philippedc/Arduino-Uno-Wind-Turbine-MPPT-Regulator/final v1.jpeg

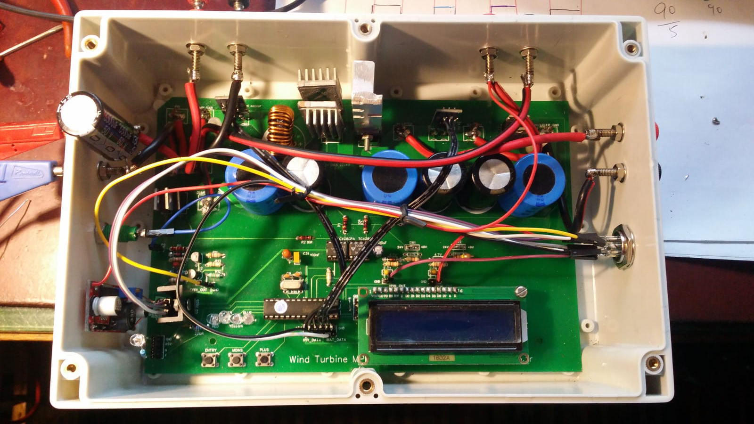
final v1.jpeg
