philippedc/Arduino-Uno-Wind-Turbine-MPPT-Regulator/photo_presentation2.png

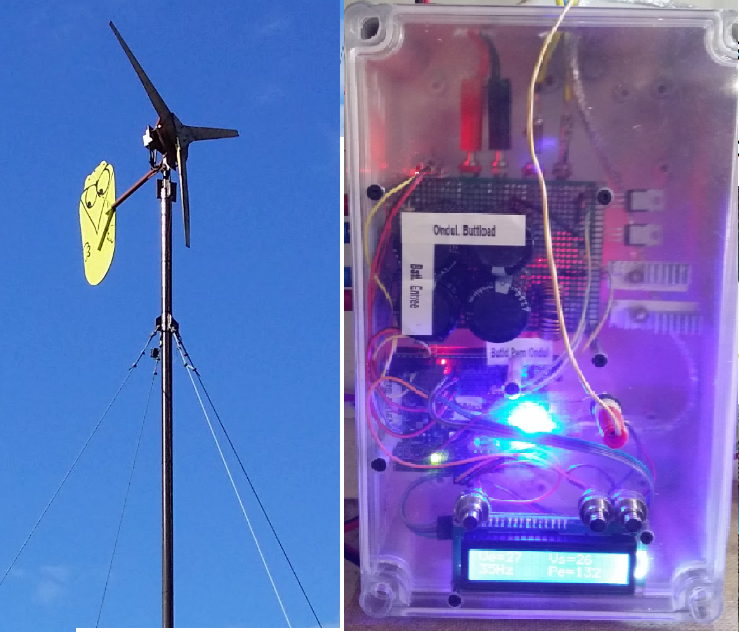
photo_presentation2.png
