philippedc/Arduino-Uno-Wind-Turbine-MPPT-Regulator/alltogether.png

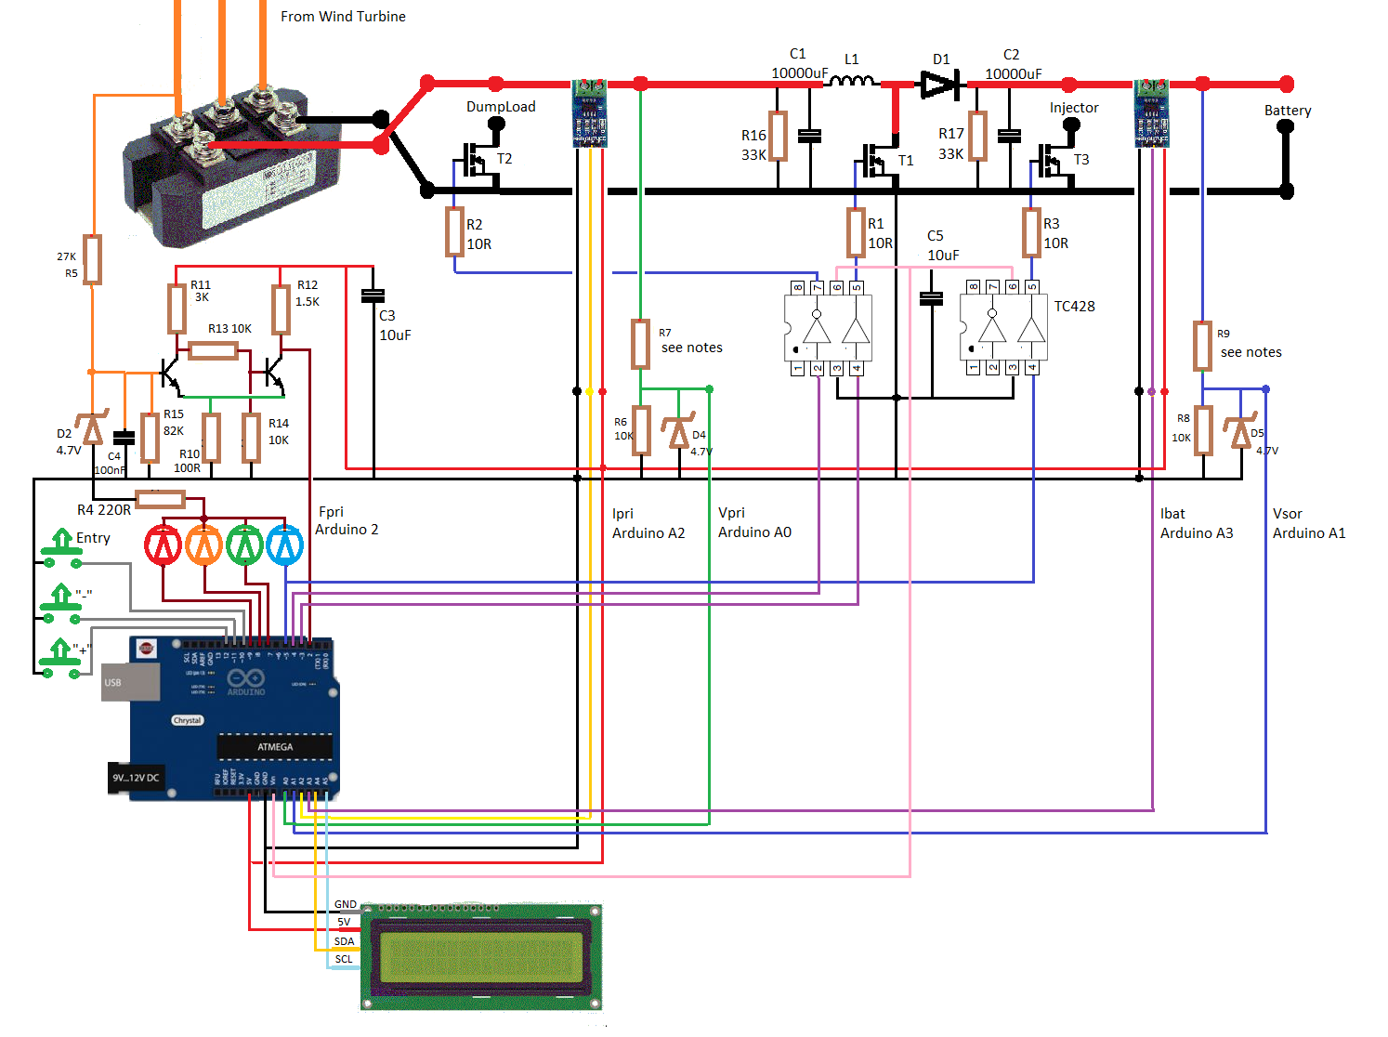
alltogether.png
