philippedc/Arduino-Uno-Wind-Turbine-MPPT-Regulator/(threads)

Thread 1 (2019-08-18):

Great, but how about breaks?

fhorst1, 2019-08-18:
I really love your solution and I am going to build 4 of them.
Buying from Aliexpress they only costs me US$ 35,- per controller :-)

But... how about brakes?
Dumpload is an expensive solution, and does not (???) protect the wind turbine during storm.

I live in a low wind speed area, off grid, 18 x 335w solar and 4x 800w wind.
This makes the wind turbines economical OK.
95% of the time wind speeds are below 5/ms
99.9% of the time the wind turbines will never get in the situation that they will overcharge the battery array (48v, 800ah lead-acid)

The 0.1%..
0r maybe even 0.001% of the time.
When there is a storm, the turbine needs to be stoped.

I'm thinking to use your dump load connection to activate a relay that shorts the 3 wires.
(with some delay) using Trigger Delay Timer Relais (https://aliexpress.com/item/32881401830.htm)
They are relatieve cheap ($0.80)  but is it possible to let the Arduino make a delayed short betweem the 3 wires?

fhorst1, 2019-08-19:
Hi Philippe,

As I currently have "0" electronic parts, I need to buy and look the liberty to make a list of the components for other people to purchase. (with price)

Personaly I like Aliexpress.
I have no connections to any of the shops, except I bought my stuff there 😃

Few questions:

For the capacitors, what is the right voltage? 80 or 100 or 200v?
The 4.7v Zeners, are they 0.5 or 1 W?
I can not find D3 in the "Alltogether.png"
Location of the 2N2222 and type (NPN?)
+++++++++++++++++++++++++++++++++++++++++++++++++++++++++++++++++

List of all materials:

One 3-phases power rectifier 150A ($7.75)
https://aliexpress.com/item/4000096163147.html

Dump load

Arduino Uno R3 ($3.25)
https://aliexpress.com/item/32213964945.html

current sensors ACS712 module, 20A ($1.25)
https://aliexpress.com/item/32831999370.html

CD display 1602 with I2C interface ($2.00)
https://aliexpress.com/item/32685612494.html

power transistor CMOS
10 x IRFB4110 ($4.25)
https://aliexpress.com/item/33024808392.html / https://aliexpress.com/item/33034172787.html
10 x IRFB4321 ($6.50)
https://aliexpress.com/item/32676708858.html
5 x IRFP4227PBF ($7.00)
https://aliexpress.com/item/32821398006.html

Schottky diode, (10 x MBR30200 = $1.75)
https://aliexpress.com/item/32876954612.html

One self of 100uH at least 15A ($4.00)
https://nl.aliexpress.com/item/32804834231.html (2 x 100uH/15A)
https://aliexpress.com/item/32804332271.html (= $5 for 3 x 100uH/15A)

electrolytic capacitors (4 x 4700uF/80v, total 10000uF or more)
what is the right voltage?? is it 80v, 100v or 200v?
https://aliexpress.com/item/33013414283.html ($11.00) (4 x 10000uF/80v)
https://aliexpress.com/item/32362931046.html ($15.00) (5 x 4700uF/80v)
2x CMOS driver circuits TC428 ($ 2.25) (for 10)
https://aliexpress.com/item/32900750979.html

2x transistors 2N2222 ($1.00) (for 100)
https://aliexpress.com/item/32944625673.html

4.7V zeners (*wattage?)
https://aliexpress.com/item/32865106042.html ($0.75) (100 x 0.5w/4.7v)
https://aliexpress.com/item/32949966611.html ($1.75) (100 x 1w/4.7v)
https://aliexpress.com/item/32864268102.html ($8.00) (100 0.5w mix 2-47v)

Electrolytic capacitors (* voltage?)
https://aliexpress.com/item/32886266800.html ($1.00) (20x 100nF, 100v)
https://aliexpress.com/item/33008525992.html ($1.00) (20x 10uF, 100v)

Resistors
set of 10 times 10, 100, 220, 1.5K, 3K, 10K, 33K, 82K Ω (NOT 27K, 91K or 380K!) 180K
https://aliexpress.com/item/32625249339.html ($4.00)
100x 27K = 27kΩ
https://aliexpress.com/item/32998450778.html ($0.15 + 0.36)
also for 24V (91K)
(alternative is to combine resistors from the set to 27, 91 or 380K)

Prototype shield for Arduino Uno R3 ($2.00)
https://aliexpress.com/item/33063183123.html
Total price: $ 48.75
(most aliexpress are free shiping, and rounded up, price is between $40 and 45,-)

extra:
Push buttons:
https://aliexpress.com/item/32992634198.html ($1.00)
Toggle switch
https://aliexpress.com/item/4000050986819.html ($0.50 for 20)
LED diode 5mm
https://aliexpress.com/item/32618633084.html ($1.00 for 5 x 20, W/Y/R/G/B)

+++++++++++++++++++++++++++++++++++++++++++++++++++++++++++++++++

Detailed List of components

C = Capacitator
C1 = 10.000uF 80V
C2 = 10.000uF 80V
C3 = 10uF 100v
C4 = 100nF (=0.1uF) 100v
C5 = 10uF 100v

D = Diode
D1 = Schottky diode MBR30200 parallelize 2 or more
D2 = Zener diode 4.7v
D3 = ???? can not find in schema
D4 = Zener diode 4.7v
D5 = Zener diode 4.7v

L = Inductor
L1 = 100uH 15A

R = Resistor
10R = 10 Ω = Brown, Black, Black, Gold	(need 3x)
100R = 100 Ω = Brown, Black, Brown, Gold	(need 1x)
220R = 220 Ω = Red, Red, Brown, Gold	(need 1x)
1.5K = 1.5 kΩ = Brown, Green, Red, Gold	(need 1x)
3K = 3 kΩ = Orange, Black, Red, Gold	(need 1x)
10K = 10 kΩ = Brown, Black, Orange, Gold	(need 4x)
27K = 27 kΩ = Red, Violet, Orange, Gold	(need 1x)
33K = 33 kΩ = Orange, Orange, Orange, Gold	(need 2x)
82K = 82 kΩ = Grey, Red, Orange, Gold	(need 1x)
91K = 91 kΩ = White, brown, orange, Gold (see notes)
180K = 180 kΩ =	Brown, Grey, Yellow, Gold (see notes)
360K =360 kΩ = Orange, blue, yellow, Gold (see notes)

R1 = 10R
R2 = 10R
R3 = 10R
R4 = 220R
R5 = 27K
R6 = 10K
R7 = see notes (91K (24V) or 180K (48V) or 2x91K)
R8 = 10K
R9 = see notes (180K (24V) or 360K (48V) or 2x180K)
R10= 100R
R11= 3K
R12= 1.5K
R13= 10K
R14= 10K
R15= 82K
R16= 33K
R17= 33K

T = Transistor
T1 = IRFB4110, IRFP4227 or IRFB4321
T2 = IRFB4110, IRFP4227 or IRFB4321
T3 = IRFB4110, IRFP4227 or IRFB4321

Transistor (with no letter or number) between R11, R12, R15 R10 and R14 are the 2N2222 NPN??

philippedc, 2019-09-04:
Hi @fhorst1 welcome here too :)
I do not understand why I do not receive notifications when I get any post, not here nor on arduino.cc...???
Yes I understand about brakes, we do not have this trouble with Piggott wind turbines.
What I suppose in case of very big storm, despite the dumpload is switch on, the voltage still increase over the nominal voltage value. In this case a duplicate dumpload circuit where the dumpload resistor is a short circuit may be the solution. Your link to the Trigger Delay Timer Relais does not operate.

Right now I'm working for a PCB. Then I will work for the version 2.0 with some changes : 10000uF capacitor for input of the inverter, low power state for the ATmega328 when it is not windy,  with an alarm (buzzer) if Vsor is under VsorMin, and an alarm if overload is reach in case of storm.

fhorst1, 2019-09-05:
Hi Philippe,

thank you for contacting me.

I have not that knowledge about electronics...
as far as I understand you (we) already use 10.000uf, yes?

[image: image.png]

I've done some googling about the ATmega328, if i understand it correctly
it is to replace the arduino ???
(but also that it is the arduino chip.... LOL sometimes being a noob makes
this difficult to understand)
I was not aware the Arduino uses much power :-)

Alarm (buzzer) if Vsor is under VsorMin,  does not make a whole lot sense
for me.
I use 6KW inverter to convert my 48 DC to 230AC. If the battery array is
below 10%, that one makes a loud beep and stops working.
Standby mode is already about 100 watts.... without really inverting energy.

That is just me, but i think most people will want to charge their
batteries, and want to convert this charge to AC230 (or110)
Most (maybe all?) inverters use more energy in standby mode than the MTTP
will.
A buzzer would give an alarm, but what do you expect people to do then this
buzzer goes?

Real life for me is when the inverter starts to cry, i know the batteries
are low and i need to put my laptop to hibernate.
The rest of the equipment (refrigerator, airconditioning etc) will just
stop working.

What would you like me to do with the MTTP's?
Turn them off?
I don't think that is a good idea, as controllers are meant just to be
there and do their thing, without constant interference.
Many systems are hybrid, have solar and wind.  When will the Vsor be under
VsorMin ?
Mostly at night, really early morning... You are sleeping.
Buzzer goes and you wake up, realising that the battery levels are too low.
What will you do?
Get out of bed to stumble in the night towards the setup and do??
:-)

I'm trying to help with your thoughts, how they will translate in practical
life (at least my life)

Why would the Trigger Delay Timer Relais not operate?
To my understanding simply short the 3 wires is a quick and dirty brake.
Abrupt, what might give damage to the turbine and/or blades.
short 2 of the 3 is like half brake, slowing down, adding a few seconds
later the third wire will give the same hard stop, but the speed is already
drastically reduced.
it would require 2 times the Trigger Delay Timer Relais per MTTP. First one
shorts 2 wires, second one shorts also 2 wires.
as there are 3, and the 2 pairs are different pairs, both shorts will give
a 3 wire short.
the trigger is the power (or pulse) you would normally provide to switch to
the dump-load, yes?

When the voltage is too high, the T2 makes the connection to the dump-load.
R2 is the line that triggers T2 to switch to dump-load, yes?
if I would not connect it to T2 i can connect it to both trigger
connections of the Trigger Delay Timer Relais  (who have different time
settings)

Please correct me if I'm wrong.
I am a beginner in reading those drawings, but a quick study :-)

The alarm if overload is reach in case of storm  you where planning, that
one would be even more nice for me to use as trigger.

A dump load resistor is for me not easy to accomplish.
Thailand is already HOT (last "summer" (hot season) 44 degrees Celsius)
I could use a heating element,
https://www.aliexpress.com/item/32991460130.html , mount them outside the
house.
In the rear situation the battery array is full (sunny, cool days, and
there is too much wind) they can be used as dumpload.

But it does leave me with the  typhoon  scenario. And thrust me, that is
not a doom scenario but realistic one.
A few days back there was a typhoon in Asia and its course was projected to
go directly over our house.....
Lucky for us it reduced in power when it was on land (Vietnam, after this
Cambodia)
Many floods in the area, but we got lucky, this time.
we don't need to buy a new roof :-)

But, typhoons are a real problem.

It would be great if you could help me to make the Trigger Delay Timer
Relais work.
I am not always at home, like now I an in Holland....
That typhoon almost made me change my flight to go back 2 weeks sooner..
Lucky lucky lucky :-)

When  can you have the PCB ready??

I am in Europe till the 14th, after this you need to send to Thailand :-)

When i'm back home, all the parts have arrived, and i am planing to start
soldering this thing and try to make it work.
If you like, you are more that welcome to help me.

I can't pay for your trip, but your stay would be free, and you can see
lovely Thailand Isaan country :-)
Trip from Bangkok to Udon Thani airport is no problem to pay for you, and
we pick you up at the airport .

My email address is fhorst@gmail.com
Whatsapp +31653653474
line: sirquest2017

Best regards,

Frank
.

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

philippedc, 2019-09-10:
Hi, when do you plan to build the regulators ?
I'm working on the PCB, and V2 also, but before I would like to finish the bench of measure, with an anemometer, to be able to measure the benefit of the device.
My email is dcphilippe"at" yahoo.fr
Thanks

philippedc, 2019-09-10:
> it would require 2 times the Trigger Delay Timer Relais per MTTP. First one
shorts 2 wires, second one shorts also 2 wires.
as there are 3, and the 2 pairs are different pairs, both shorts will give
a 3 wire short.

What I can say : in case of high storm, either you break the wind turbine, either you can burn the 3 coils : You must not short 2 wires. It must the 3 at the same time. But at the beginning for a short time only to dissipate the heat, for instance :
- short for half a second, delay for 1 second,
- short for half a second, delay for half a second
- ......
- short for a second, delay for a second
- short definitively

fhorst1, 2019-09-10:
Hi Philippe,

I'm kind of confused, as many information does not come from official
education, but trying to grasp using the internet.

What i read about was that shorting 2  of the 3 strators will reduce the
speed of the turbine.
of as a fact any 3 phase motor.

short 3 wires does the same, but more abrupt.
even that abrupt that it could put great force on the blades and axes that
one of them will snap.

I'm aware electric magnets can be crazy powerful

If my understanding is correct, you can measure the rpm by frequency.
the rpm is controlled my the MTTP,
is it possible to set a max rpm?

a kind of threshold where it is still safe to use the breaks?

It is a situation that will occur 2 or 3 times a year.
To heavy storms.
only problem is that I do not know when they will occur and if i will be in
the area to be able to manually stop the turbine. (prior to the storm)

I'm not the only one with this problem, most cheap systems (for turbines
without pitch control and real brakes) they use the 3 wire short.
nothing sexy, just stop.

9 out of 10 times this will work fine.
but it is a big stress.

that is why i start searching for more gently ways, and read about was that
shorting 2  of the 3 strator will reduce the speed of the turbine.
of as a fact any 3 phase motor.

Next month I can test onsite.
just by hand short 2 wires and see if it does work as brake.
now it is all just theory :-)

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

philippedc, 2019-09-11:
Hi, I've just ordered PCB. I have to test it before publishing it.

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

fhorst1, 2019-09-14:
I looked at the pricing in Holland for the 4700 and the 10000
4700 is about 6 or 7 euro, the 10000 20 Euro's.

That is quite a price difference!!
2.30 (USD) or 20 euro...

Better buy in China :-)

If all works OK, I always can change them to Japanese brand.
(If they quit working fast)

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

fhorst1, 2019-09-29:
And here my email address also :-)

Thank you for sharing!

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
>>> Nooo, it is 6x 4700 or 3x 10000uf. 4700uf are more than twice less
>>> expensive than 10000.
>>> What you see for the 7th is the self. I could not find the right symbol,
>>> so I use a capacitor....
>>>
>>> —
>>> You are receiving this because you were mentioned.
>>> Reply to this email directly, view it on GitHub
>>> <https://github.com/philippedc/Arduino-Uno-Wind-Turbine-MPPT-Regulator/issues/1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>,
>>> or mute the thread
>>> <https://github.com/notifications/unsubscribe-auth/ADVGBDG4NBOJDVGCFSOJ2BTQJJV47ANCNFSM4IMTSTPA>
>>> .
>>>
>>

fhorst1, 2019-10-01:
Hello,

I am in the process of ordering 15 PCB.
But 5 need to go to my home address in Thailand, and 10 to my friends
address in France.

Is this possible, and if so, how do I arrange this?

Best regards,

Frank van der Horst

kubeqsq, 2022-03-17:
Hello, do you have any PCB drawing or .sch??

philippedc, 2022-03-17:
Hi, I can provide pcb. You will find my email in the manual.

Thread 2 (2019-09-02):

Why boost converter?

martinjaeger, 2019-09-02:
Hey, very cool project!

Recently I also thought about a wind turbine MPPT, but I considered a buck converter (battery at low voltage side, wind turbine at higher voltage side) as most suitable DC/DC converter topology, at least for 12V / 24V systems.

Can you please tell a bit more about expected real-life voltage levels reached by the turbine according to your experience? Would we loose much of the energy if we use a buck converter and can't charge the battery at input voltages below battery voltage?

And is stated current in the document meant for the input or output side?

philippedc, 2019-09-04:
Hi @martinjaeger  I kwew a little about DC-DC converter, but nothing about wind turbine regulators. All literature I read was about PV regulators, they are all buck. But the power answer of a PV is NOT like a wind turbine, even if they are similar. So as I did not know how to do the very first experimentation have been made with a buck-boost inverter converter, with the idea that if the input is too low the boost will make it reach the battery voltage, and if too high the buck....

But what I've seen that this regulator, despite its low efficiency due to the way it works, it was ALWAYS working in boost. May be it could work in buck with a big storm I never get, so, what I can say is that in usual windy environment only boost operates.
So I built a high efficient boost converter. And what I've noticed is that the regulator can operate and gives 10A under 18V. At the beginning I thought my 24V Piggott coils were not well calculated. But not : if the MPPT has found that I can get 180W under 18V that will give 10A, that means I will not get 7.5A under 24V (for the same power). If the wind increases, the voltage will increase according the the batteries charge. And so until the batteries are completely charged at 31V.
So what I can say by my practical experimentation is that the boost converter is not made to increase the output voltage, but instead to decrease the input voltage that increase the current.
VpriMax must be set to the maximum battery voltage, for instance 31V. Then exceed power will go to the Dumpload.

martinjaeger, 2019-10-01:
I read a bit more about existing wind turbine converters and probably understood why boost makes more sense. Here are my thoughts, correct me if I'm wrong:

The open circuit voltage (voltage without any load) is proportional to the turbine speed. So without an MPPT controller, the wind turbine voltage rises proportional to its rotor speed until it reaches the battery voltage and current starts to flow. The layout of the turbine must be such that the maximum power point is reached around the nominal battery voltage under most typical operation conditions.

In order to optimize the efficiency with an MPPT (i.e. DC/DC converter), there are 3 options:

1. **Boost converter (Vturbine < Vbat)**
This setup allows to generate electricity even at very low speeds where the generator voltage did not yet reach battery voltage. As soon as we approach the battery voltage, the MPPT algorithm doesn't work anymore and the turbine voltage is fixed to the battery voltage. This seems to make sense especially for off-grid systems where it's necessary to get high efficiency when there is not much energy available. If we waste a bit of energy when the turbine generates a high amount of energy anyway, this might not be a big issue.

2. **Buck converter (Vturbine > Vbat)**
In order to make this concept work, it makes sense to use a turbine with higher nominal voltage than the battery system, so e.g. use a 48V turbine with a 24V battery system. This allows to start charging at comparably low speeds already and reach the MPPT in any operation point at higher loads, only limited by the maximum voltage/power of the converter.
However, the voltage under open circuit conditions (e.g. if the battery is full) might get very high, which needs to be considered in the electronics design. A dump load could be used to limit the voltage, but as far as I understood, Hugh Piggott turbines are sometimes operated without a dump load as the turbines are mechanically protected from damage at high wind speeds.
In a grid tied system I guess this approach makes most sense, as you can feed in the energy even if the batteries are already full.

3. **Buck/boost converter**
Combines advantages of both above approaches, but also makes things more complicated + expensive.

philippedc, 2019-10-01:
Yes, you are right, Except for the advantage of the buck as I do not see the advantage in grid tie configuration. Of course in boost also I feed power when batteries are full!
Buck could make sense in very stormy country and very poor need of power. But I will have to brake the speed in that case.

martinjaeger, 2019-10-01:
> Of course in boost also I feed power when batteries are full!

Yes, but with the boost converter you can't do MPPT anymore after the the generator voltage reached the battery voltage, which is always the case in very windy conditions. So in this case you don't get the highest efficiency, whereas with the buck layout you could still track the MPP.
What I wanted to say is that in off-grid applications efficiency at low wind is more important and it doesn't matter if you can't do MPPT anymore when you have lots of power/energy available anyway.

philippedc, 2019-10-02:
Yes you're right. Nevertheless I seceded to reach 700W under 24A with my little 350 W Piggott wind turbine, and I never got those results with the past Chinese regulator.

rinntimo, 2020-01-16:
What kind of coil you have in your DC/DC converter?
If I undestood correctly the Arduino with Pin 3 offers only 490 Hz PWM output?
Pins 5 and 6 would give 980 Hz but is it enough either?
When I simulated the circuit it seems that relatively high inductance value is needed. I consider 100mH or more for this 490 Hz.
I have a wind turbine of "2kW" and it gives relatively high voltage when it starts rotating. With a speed of 70 rpm (little over 1 round per second) it gives already 100 Vdc unloaded, rectified. Therefore I have been looking for PPT (Peak Power Tracker) for the wind turbine. I already had MPPT for solar panels, but as you wrote that MPPT works wery different than PPT for wind. It might work somehow without the PPT but I think I will loose quite a lot potential when the high current is breaking down the turbine and it stay on very low power coefficient area. So for my wind turbine I make a Buck (StepDown) converter. The challege is the relatively high voltage on the turbine, as with 260 rpm it gives already 400Vdc. In some studies it has been noted that for 3 blade horizontal axis turbine the highest Cp is found at tip-speed-ratio of 6-7.
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
I my turbine this situation should achieve already in 5 m/s wind speed -> rotating speed of 170 rpm (which would give unloaded rectified voltage of 260Vdc).
So I need the Buck anyway. The battery I have for now is 24V so the "full power" current to empty batteries (~20Vdc) is close to 100A. That 260 rpm is so high speed that there is no use to let it rotate faster, so that can be the maximum speed thus the maximum voltage is 400V.
I consider higher frequency for the switching speed.
Any thoughts?

philippedc, 2020-01-16:
Pwm is 490hz by default with atmega328p, but it is possible to modify registries for a higher frequency. The regulator works with a cutting frequency of 31khz.

philippedc, 2020-01-16:
In the manual I give the link where I 've bought the coil.

rinntimo, 2020-01-17:
Thank you for your answers!
☺

Br,
Timo Rinne

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

pulledbeef, 2020-03-12:
Hey,
I am quite new to MPPT and find your project quite well documented. Thanks.
I still have a questions concerning the mppt with the boost converter. Lets say I have a 12V load (battery or something else). So the boost converter shall convert whatever voltage beneath 12V comes from the rectifiert to 12V, right. So your T1 Transistor of your DC/DC converter will be triggered that 12V are established, right? Coming from the MPPT perspective the transistor should be triggered that the maximal power is retrieved from turbine. How are both tasks managed with one DC/DC converter? Hope my problem with understanding it right is understandable?

Thanks

philippedc, 2020-03-14:
@pulledbeef hi, as your working voltage is 12V, the DC-DC converter will work from about 3V to 12V. If your wind turbine gives 14V, the output will be 14V (a little less because of the lost in the rectifier diode). Boost is surprising many people, except if you are considering that voltage and current delivered by the wind turbine are floating. P=V*I, and the only fixed value is Vout = 12V. So the boost effect with a fixed output voltage will adjust the Vin for a best P.
Instead of solar panels a wind turbine is much more a current (in Ampere) generator, that is why a buck converter does not work.

pulledbeef, 2020-04-16:
Hey, thanks for the quick feedback.
I still dont fully understand you.
What do you mean by voltage and current are floating?
Using a boost converter to deliver a fixed 12V output will result that the pwm of the transistor will be adjusted depending on Vin, right? But how are you controlling the Vin with the boost converter? Sorry for not getting it

rinntimo, 2020-04-17:
Hi @philippedc and @pulledbeef !
I am not quite sure what you mean the buck converter does not work for wind turbine.
The available power from the wind is relative to cubed wind speed (power of 3).
Therefore the MPPT is used for adapting the input voltage (rotation speed) so that you get the maximum power to use. Here are the possible power curves for different wind seeds and the idea of tracking the maximum power point. (It doesn't matter how you control it; in big wind turbines usually the pitch control is used)
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
If you have only "straight connection" from rectifier to battery (as most of the small wind charge controllers basicly do) there are 2 faults:
1) You get no power output until the generator voltage output is above the battery voltage.
2) After you have reached the battery voltage you are limited in power by the electrical characteristic of the generator; internal resistance and maximum current affects, and the aerodynamical charasteristics of the wind turbine it self; it can not give you more power than the increase of torque (= increase of current) output can give; you have fixed the voltage that kind of fixes also the rotation speed. Increasing current will increase the torque and the maximum torque is limited when you run very low tip speed ratio.
Here you see the torque curve shapes of a wind turbine with different wind speeds:
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
If you stay on the maximum torque you loose power as well (as the dotted line is still the same maximum power curve) and if your voltage (~rotation speed) is limited you can not even climb up to the maximum torque point but you are loosing more power.
With the boost converter only you can fix the "fault 1" in the list above and your power curve is like this:
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
This is some real measurements both in wind tunnel and real world:
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

Of cource you can double your maximum power output if you have a "12V generator" rated 350W and you double the battery voltage you can get 700W out of it (because of the maximum current it can deliver is what it is).
If you have most of the winds so small that the rotation speed gets very seldom above the "battery voltage speed" then the boost converter only is fine. If you have also bigger wind speeds you should use a buck-boost converter to get the most out of it. But that is much more difficult to control...

As I understand the permanent magnet generator still behaves like "voltage source": if you increase speed you get more voltage. I understand the difference to solar panels behavior, where the maximum voltage can be much higher than the "maximum power output voltage" - it has relatively high internal impedance. Then the increase of current with the same solar input gives you rapidly less power because the output voltage drops easily when you increase load. Thats what the solar MPPT does; adapts the weak input impedance to the rigid impedance of a battery.
My wind turbine is quite big as a small wind turbine; blade length is about 1,5 m. And the generator voltage rises quite rapidly. I don't need the boost option as it reaces the voltage of a 24V battery right when it starts to rotate, but without a buck converter I will loose almost 90% of the potential power output.
Of course at "maximum voltage" (or unreasonable speed) you have to brake it down first by increasing the load current and at last shorting the windings.
I will try to convert this Arduino project to control a bigger Buck converter for my wind turbine, as the voltage can get more than 200V with that ludicrous rotation speed and the rated power of the generator is something like 2kW with a huge ability of delivering current output.

As an answer to @pulledbeef question: how to control the "input voltage" with the DC/DC converter;
If you increase the current it increases torque and depending the turbine and the wind speed that affects the rotation speed more or less, and the "input voltage" (= generator output voltage) is affected because of that. Hope the curves (I found from the Internet by Google picture search) clarifies this a bit more....

pulledbeef, 2020-04-17:
Wow,
thanks for the details.
Looking at the boost scenario I still can fully understand it:
Let's say we have a 12V Battery. The turbine is producing 10V freerunning. Using a Boost converter we can boost the input voltage of the turbine to the battery voltage of 12V. As soon as we would start using the boost converter the turbine Voltage would decrease as we are putting some load on it. As the boost converter will be triggered in order to reach the fixed 12V of the battery, how can it also be used to put the wind turbine in optimal power point? The pwm for triggering the boost converter will be set so that 12V or whatever loading voltage for the battery is set. For example we have a wind of 3m/s and the optimum power of the windturbine would be at 8V, how can we put the windturbine into that working spot with the same boost converter?

philippedc, 2020-04-17:
@rinntimo many thanks for your explanations, you do it better I could.

Note that my first prototype was a buck boost inverter DC DC converter. Dispite the liw efficiency of this kind of converter, I noticed it never worked in buck mode. But always in boost, or with a ratio of 0.
Even if those tests have not been done during a storm, this can suppose that the turbine voltage optimal operation is  below Vmax, eg 31V for my 24V batteries set.

My only experience are with Piggott wind turbines, 3 different sizes. So... But, if you can reach "easily" 200V, may be your turbine is more appropriate for a 48V or 96V battery set, than a 24V.

rinntimo, 2020-04-17:
@philippedc You are welcome!
Yes my wind turbine/generator might be good straight to 96V battery system, but for convenience I prefer 24V batteries for many device is easier to find using straight 24V or 12V after my 24V-to-12V voltage adapter / 12V battery charger... Any way then I would need the Boost converter for small winds. And it is easier to find 2 similar 12V batteries to put in series than 4 or 8... when the battery pack needs to be enhanced/replaced. :)

@pulledbeef Lets put it this way: The Boost converter is not _setting_ the output voltage to 12V because it already is that, if you are connected to a 12V battery. It is a matter of "pumping" charge through current flow from the generator (lower voltage level) to the battery (fixed but higher voltage level), like an in-house air-heat-pump is doing in air conditioning device.
Also this animation (first 5 minutes) might get you some idea: [https://www.youtube.com/watch?v=vwJYIorz_Aw](https://www.youtube.com/watch?v=vwJYIorz_Aw)
Here they have a battery with "rigid" voltage at the input and a variable voltage to the output load, but in wind generator-to-battery -case it is just the opposite. Anyway the MPPT Boost converter is draining as much current as possible from the generator to the battery, so that the generators power output
P = U x I
is maximum possible. As the generators voltage drops when you drain more current (~torque) than the power from the wind at that moment is allowing you to drain. So it is kind of adjusting the rotating speed as well.

pulledbeef, 2020-04-17:
@philippedc
thanks dude. Yeah the point I was missing is indeed that the battery is setting the voltage. Thanks

MafuLynch, 2021-05-31:
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

Hi, I have been looking into making a MPPT controller myself too. My understanding of how it works and why it only owrked in boost for you is because of the turbine desing. When you read piggott books he calculates the ammount of turns in the coil and rotor diameter to get the rated voltage at your desired speed. For it to work as buck you should need it to be much higher. I am looking to make a 48v wind turbine, so following piggott recepie I should do 4 coils of 90 turns, but I am looking to make 5 coils at 150 turns each, this way the rated voltage will increase to 100V aprox when loaded. This means in low wind I would get 48V with low rotating speed and as wind increases voltage will increase too.
I am still analyzing the advantage of doing this mode vs a boost converter. I have read several IEEE papers about turbine MPPT controller and they all talk about using buck converters only. I believe the reason is you can get more power out of it, since the current will opose the wind torque on the turbine. So at same current, same oposing torque but with higher voltage you get higher electrical power.

So what I  am trying to say is there is no right way going for boost or buck converter, but it depends on the design of the turbine since with one that was designed with to operate at 48V would need too high wind to maintain a proper TSR and produce high voltage.
Will keep posted on any progress I manage to do.

Your proyect has been very helpfull for me to orientate my ideas

philippedc, 2021-05-31:
hi @MafuLynch, it would be great to get your source about IEEE papers about buck wind turbine.

Since now I am experimenting the regulator for a pair of years. The code has been improved (v3, not published yet  because a luck of time to update the manual) with the help of several contributors, thank to them.

They also shared other models of wind turbine regulators, for instance this one : https://mousa-simple-projects.blogspot.com/2020/07/mppt-wind-charge-controller-reverse.html
It is also a boost controller.

MafuLynch, 2021-05-31:
@philippedc I will attach some of the papers I have read. I have several more pending to read still.

This is not an IEEE paper, but it has some interesting info in how they increased the efficiency of the buck converter
[751830.pdf](https://github.com/philippedc/Arduino-Uno-Wind-Turbine-MPPT-Regulator/files/6572325/751830.pdf)

[soetedjo2011.pdf](https://github.com/philippedc/Arduino-Uno-Wind-Turbine-MPPT-Regulator/files/6572343/soetedjo2011.pdf)

[matecconf_icudr2019_03004.pdf](https://github.com/philippedc/Arduino-Uno-Wind-Turbine-MPPT-Regulator/files/6572348/matecconf_icudr2019_03004.pdf) this one also wasn't IEEE but also interesting.

I will go through all the colection of papers I have and sort them out and share them. Because lots of them had some nice information but not quite applicable to these type of turbines and I can't identify now the ones I liked.

But it is my understanding that both methods are possible. I also have a paper somewhere where thay are using a boost too.

MafuLynch, 2021-05-31:
Let me share with you also this comment on Hugh Piggott book.

"So far the assumption has been that the voltage is clamped by a battery. You can also consider changing the operation voltage in response to changes in speed of a given alternator. This is sometimes called 'maximum power point tracking' (MPPT). It's quite an exciting avenue of wind turbine development.
In low winds, the alternator can only generate relatively low voltage, whereas in high winds it has the ability to produce much higher voltage. Connecting it directly to the battery handicaps its efficiency by tying it to the same voltage under all coonditions. Using a converter to change the voltage allowing it to rise in higher winds, has several benefits.

- The alternator losses depend on the square of the current, so an increase in voltage and corresponding reduction in current (for a given power output) cuts the losses in the coils, saving energy and avoiding overheating.
- The blades will work best at a constant tip speed ratio which implies that the rotational speed should change in direct proportion to windspeed. Working a constant voltage implies working at a more like a constant speed, whereas using a converter allows you to vary the alternator speed more widely.

...

The basic direct battery-charging design without a converter has poor efficiency in stronger winds because of the high resistance in the stator(caused by the need to cutt in at low rpm) and also the tendecy to stall the blades (for the same reason)..."

He just compares using DC-DC converters vs direct  connecting to the battery, but he only talks about going up in voltage.

I am by no means a wind energy expert, but I understand out of this that if the turbine is designed to generate 48V at low rpm (which would depend on the ammount of turns per coil, number of coils and strength of magnet) will allow to go higher and have a better efficiency. I am still to find a paper that compares the performance of using low voltage and rising to high voltage vs producing high voltage and lowering it. I would find this very interesting and would like to do the research for it at some point.

But I really admire your work. My comment was going to that I think that the difference in using a boost or buck also depends on the turbine design since you might need too high wind to reach high voltages if it was not designed to generate those high voltages.

In his website Hugh also talks about some people in france using 5 coils per phase with 260 turns pero coil, allowing it to go much higher in voltage.

Thread 3 (2019-12-02):

Variable type to small to hold return value of millis()

HenniePeters, 2019-12-02:
Hi Philippe,

I have a question about the fet drivers. Did you select the tc428 with one inverting and one non inverting driver on purpose or was it just what you had in stock?
Why not the TC427 with two non inverting drivers?

And a remark about your code:

The millis() function returns an unsigned long. You store that in an unsigned int. I expect that during testing you will never notice the problem because an overflow in millis occurs after 70 hours, but at some point your code will fail.
I've changed all the "tempo" variables in my instance of the code to unsigned long. Also the variables that start with "somme".

philippedc, 2019-12-02:
Hi Peter I well receive notifications now ;)
Yes I had in stock TC428, that is why....
About millis. I'm not an expert in C.... What happens when you add +1 to an unsigned integer of FFFF (hex)? As I know it restarts from 0.
I've chosen unsigned integer instead of unsigned long because it may be quicker.

HenniePeters, 2019-12-03:
I see what you mean, it will be faster. I hope that it will work correctly during the overflow of the  millis() function. I will test that when I can find some time.

Thread 4 (2023-09-16):

pcb

dessis37, 2023-09-16:
Can i buy the pcb of you or can i buy the pcb file?

Best regard dennis

philippedc, 2023-09-17:
Hi Dennis, I can ship a PCB. Where do you live ?

Bonne journée,Philippe de CraeneINAKAKOURA SAStel: 06 31 05 83 21
www.inakakoura.com

    Le samedi 16 septembre 2023 à 14:39:13 UTC+2, dessis37 ***@***.***> a écrit :

Can i buy the pcb of you or can i buy the pcb file?

Best regard dennis

—
Reply to this email directly, view it on GitHub, or unsubscribe.
You are receiving this because you are subscribed to this thread.Message ID: ***@***.***>

dessis37, 2023-09-17:
Hi i live in denmark and whats the cost of the pcb?

Sendt fra Outlook til iOS<https://aka.ms/o0ukef>
________________________________
Fra: PhilippeDC ***@***.***>
Sendt: Sunday, September 17, 2023 9:53:16 AM
Til: philippedc/Arduino-Uno-Wind-Turbine-MPPT-Regulator ***@***.***>
Cc: dessis37 ***@***.***>; Author ***@***.***>
Emne: Re: [philippedc/Arduino-Uno-Wind-Turbine-MPPT-Regulator] pcb (Issue #4)

Hi Dennis, I can ship a PCB. Where do you live ?

Bonne journée,Philippe de CraeneINAKAKOURA SAStel: 06 31 05 83 21
www.inakakoura.com

Le samedi 16 septembre 2023 à 14:39:13 UTC+2, dessis37 ***@***.***> a écrit :

Can i buy the pcb of you or can i buy the pcb file?

Best regard dennis

—
Reply to this email directly, view it on GitHub, or unsubscribe.
You are receiving this because you are subscribed to this thread.Message ID: ***@***.***>

—
Reply to this email directly, view it on GitHub<https://github.com/philippedc/Arduino-Uno-Wind-Turbine-MPPT-Regulator/issues/4#issuecomment-1722417698>, or unsubscribe<https://github.com/notifications/unsubscribe-auth/A6QI6PQS56A4WE3HNINKIITX22T6ZANCNFSM6AAAAAA423T6JY>.
You are receiving this because you authored the thread.Message ID: ***@***.***>

philippedc, 2023-09-17:
can you give a valid email so that I can share the new version manual file ?
The Manual is 4.5Mo

Bonne journée,Philippe de CraeneINAKAKOURA SAStel: 06 31 05 83 21
www.inakakoura.com

    Le dimanche 17 septembre 2023 à 10:04:51 UTC+2, Philippe DC ***@***.***> a écrit :

 Hi, Here is the last version of manual. I have v3 and v4, may be a last v2 I have to check.
It is 18€ shipping include. My Paypal is ***@***.***
Please note: according to the diagram, C8 / C9 must be a much smaller capacitive value than described: 100uF only. Otherwise T3 can break by current overflow when switching on.

Thanks,

Bonne journée,Philippe de CraeneINAKAKOURA SAStel: 06 31 05 83 21
www.inakakoura.com

    Le dimanche 17 septembre 2023 à 09:56:40 UTC+2, dessis37 ***@***.***> a écrit :

Hi i live in denmark and whats the cost of the pcb?

Sendt fra Outlook til iOS<https://aka.ms/o0ukef>
________________________________
Fra: PhilippeDC ***@***.***>
Sendt: Sunday, September 17, 2023 9:53:16 AM
Til: philippedc/Arduino-Uno-Wind-Turbine-MPPT-Regulator ***@***.***>
Cc: dessis37 ***@***.***>; Author ***@***.***>
Emne: Re: [philippedc/Arduino-Uno-Wind-Turbine-MPPT-Regulator] pcb (Issue #4)

Hi Dennis, I can ship a PCB. Where do you live ?

Bonne journée,Philippe de CraeneINAKAKOURA SAStel: 06 31 05 83 21
www.inakakoura.com

Le samedi 16 septembre 2023 à 14:39:13 UTC+2, dessis37 ***@***.***> a écrit :

Can i buy the pcb of you or can i buy the pcb file?

Best regard dennis

—
Reply to this email directly, view it on GitHub, or unsubscribe.
You are receiving this because you are subscribed to this thread.Message ID: ***@***.***>

—
Reply to this email directly, view it on GitHub<https://github.com/philippedc/Arduino-Uno-Wind-Turbine-MPPT-Regulator/issues/4#issuecomment-1722417698>, or unsubscribe<https://github.com/notifications/unsubscribe-auth/A6QI6PQS56A4WE3HNINKIITX22T6ZANCNFSM6AAAAAA423T6JY>.
You are receiving this because you authored the thread.Message ID: ***@***.***>

—
Reply to this email directly, view it on GitHub, or unsubscribe.
You are receiving this because you commented.Message ID: ***@***.***>

dessis37, 2023-09-17:
***@***.*** or ***@***.*** thank you

Sendt fra Outlook til iOS<https://aka.ms/o0ukef>
________________________________
Fra: PhilippeDC ***@***.***>
Sendt: Sunday, September 17, 2023 10:26:50 AM
Til: philippedc/Arduino-Uno-Wind-Turbine-MPPT-Regulator ***@***.***>
Cc: dessis37 ***@***.***>; Author ***@***.***>
Emne: Re: [philippedc/Arduino-Uno-Wind-Turbine-MPPT-Regulator] pcb (Issue #4)

can you give a valid email so that I can share the new version manual file ?
The Manual is 4.5Mo

Bonne journée,Philippe de CraeneINAKAKOURA SAStel: 06 31 05 83 21
www.inakakoura.com

Le dimanche 17 septembre 2023 à 10:04:51 UTC+2, Philippe DC ***@***.***> a écrit :

Hi, Here is the last version of manual. I have v3 and v4, may be a last v2 I have to check.
It is 18€ shipping include. My Paypal is ***@***.***
Please note: according to the diagram, C8 / C9 must be a much smaller capacitive value than described: 100uF only. Otherwise T3 can break by current overflow when switching on.

Thanks,

Bonne journée,Philippe de CraeneINAKAKOURA SAStel: 06 31 05 83 21
www.inakakoura.com

Le dimanche 17 septembre 2023 à 09:56:40 UTC+2, dessis37 ***@***.***> a écrit :

Hi i live in denmark and whats the cost of the pcb?

Sendt fra Outlook til iOS<https://aka.ms/o0ukef>
________________________________
Fra: PhilippeDC ***@***.***>
Sendt: Sunday, September 17, 2023 9:53:16 AM
Til: philippedc/Arduino-Uno-Wind-Turbine-MPPT-Regulator ***@***.***>
Cc: dessis37 ***@***.***>; Author ***@***.***>
Emne: Re: [philippedc/Arduino-Uno-Wind-Turbine-MPPT-Regulator] pcb (Issue #4)

Hi Dennis, I can ship a PCB. Where do you live ?

Bonne journée,Philippe de CraeneINAKAKOURA SAStel: 06 31 05 83 21
www.inakakoura.com

Le samedi 16 septembre 2023 à 14:39:13 UTC+2, dessis37 ***@***.***> a écrit :

Can i buy the pcb of you or can i buy the pcb file?

Best regard dennis

—
Reply to this email directly, view it on GitHub, or unsubscribe.
You are receiving this because you are subscribed to this thread.Message ID: ***@***.***>

—
Reply to this email directly, view it on GitHub<https://github.com/philippedc/Arduino-Uno-Wind-Turbine-MPPT-Regulator/issues/4#issuecomment-1722417698>, or unsubscribe<https://github.com/notifications/unsubscribe-auth/A6QI6PQS56A4WE3HNINKIITX22T6ZANCNFSM6AAAAAA423T6JY>.
You are receiving this because you authored the thread.Message ID: ***@***.***>

—
Reply to this email directly, view it on GitHub, or unsubscribe.
You are receiving this because you commented.Message ID: ***@***.***>

—
Reply to this email directly, view it on GitHub<https://github.com/philippedc/Arduino-Uno-Wind-Turbine-MPPT-Regulator/issues/4#issuecomment-1722423784>, or unsubscribe<https://github.com/notifications/unsubscribe-auth/A6QI6PWM6S527TNBBZYS2GLX22X4VANCNFSM6AAAAAA423T6JY>.
You are receiving this because you authored the thread.Message ID: ***@***.***>

philippedc, 2023-09-17:
***@***.*** or ***@***.*** ???

Bonne journée,Philippe de CraeneINAKAKOURA SAStel: 06 31 05 83 21
www.inakakoura.com

    Le dimanche 17 septembre 2023 à 10:35:17 UTC+2, dessis37 ***@***.***> a écrit :

***@***.*** or ***@***.*** thank you

Sendt fra Outlook til iOS<https://aka.ms/o0ukef>
________________________________
Fra: PhilippeDC ***@***.***>
Sendt: Sunday, September 17, 2023 10:26:50 AM
Til: philippedc/Arduino-Uno-Wind-Turbine-MPPT-Regulator ***@***.***>
Cc: dessis37 ***@***.***>; Author ***@***.***>
Emne: Re: [philippedc/Arduino-Uno-Wind-Turbine-MPPT-Regulator] pcb (Issue #4)

can you give a valid email so that I can share the new version manual file ?
The Manual is 4.5Mo

Bonne journée,Philippe de CraeneINAKAKOURA SAStel: 06 31 05 83 21
www.inakakoura.com

Le dimanche 17 septembre 2023 à 10:04:51 UTC+2, Philippe DC ***@***.***> a écrit :

Hi, Here is the last version of manual. I have v3 and v4, may be a last v2 I have to check.
It is 18€ shipping include. My Paypal is ***@***.***
Please note: according to the diagram, C8 / C9 must be a much smaller capacitive value than described: 100uF only. Otherwise T3 can break by current overflow when switching on.

Thanks,

Bonne journée,Philippe de CraeneINAKAKOURA SAStel: 06 31 05 83 21
www.inakakoura.com

Le dimanche 17 septembre 2023 à 09:56:40 UTC+2, dessis37 ***@***.***> a écrit :

Hi i live in denmark and whats the cost of the pcb?

Sendt fra Outlook til iOS<https://aka.ms/o0ukef>
________________________________
Fra: PhilippeDC ***@***.***>
Sendt: Sunday, September 17, 2023 9:53:16 AM
Til: philippedc/Arduino-Uno-Wind-Turbine-MPPT-Regulator ***@***.***>
Cc: dessis37 ***@***.***>; Author ***@***.***>
Emne: Re: [philippedc/Arduino-Uno-Wind-Turbine-MPPT-Regulator] pcb (Issue #4)

Hi Dennis, I can ship a PCB. Where do you live ?

Bonne journée,Philippe de CraeneINAKAKOURA SAStel: 06 31 05 83 21
www.inakakoura.com

Le samedi 16 septembre 2023 à 14:39:13 UTC+2, dessis37 ***@***.***> a écrit :

Can i buy the pcb of you or can i buy the pcb file?

Best regard dennis

—
Reply to this email directly, view it on GitHub, or unsubscribe.
You are receiving this because you are subscribed to this thread.Message ID: ***@***.***>

—
Reply to this email directly, view it on GitHub<https://github.com/philippedc/Arduino-Uno-Wind-Turbine-MPPT-Regulator/issues/4#issuecomment-1722417698>, or unsubscribe<https://github.com/notifications/unsubscribe-auth/A6QI6PQS56A4WE3HNINKIITX22T6ZANCNFSM6AAAAAA423T6JY>.
You are receiving this because you authored the thread.Message ID: ***@***.***>

—
Reply to this email directly, view it on GitHub, or unsubscribe.
You are receiving this because you commented.Message ID: ***@***.***>

—
Reply to this email directly, view it on GitHub<https://github.com/philippedc/Arduino-Uno-Wind-Turbine-MPPT-Regulator/issues/4#issuecomment-1722423784>, or unsubscribe<https://github.com/notifications/unsubscribe-auth/A6QI6PWM6S527TNBBZYS2GLX22X4VANCNFSM6AAAAAA423T6JY>.
You are receiving this because you authored the thread.Message ID: ***@***.***>

—
Reply to this email directly, view it on GitHub, or unsubscribe.
You are receiving this because you commented.Message ID: ***@***.***>

dessis37, 2023-09-17:
Dessis26 @ Gmail.com or Dessis _ 18 @ Hotmail . Com

Sendt fra Outlook til iOS<https://aka.ms/o0ukef>
________________________________
Fra: PhilippeDC ***@***.***>
Sendt: Sunday, September 17, 2023 10:38:30 AM
Til: philippedc/Arduino-Uno-Wind-Turbine-MPPT-Regulator ***@***.***>
Cc: dessis37 ***@***.***>; Author ***@***.***>
Emne: Re: [philippedc/Arduino-Uno-Wind-Turbine-MPPT-Regulator] pcb (Issue #4)

***@***.*** or ***@***.*** ???

Bonne journée,Philippe de CraeneINAKAKOURA SAStel: 06 31 05 83 21
www.inakakoura.com

Le dimanche 17 septembre 2023 à 10:35:17 UTC+2, dessis37 ***@***.***> a écrit :

***@***.*** or ***@***.*** thank you

Sendt fra Outlook til iOS<https://aka.ms/o0ukef>
________________________________
Fra: PhilippeDC ***@***.***>
Sendt: Sunday, September 17, 2023 10:26:50 AM
Til: philippedc/Arduino-Uno-Wind-Turbine-MPPT-Regulator ***@***.***>
Cc: dessis37 ***@***.***>; Author ***@***.***>
Emne: Re: [philippedc/Arduino-Uno-Wind-Turbine-MPPT-Regulator] pcb (Issue #4)

can you give a valid email so that I can share the new version manual file ?
The Manual is 4.5Mo

Bonne journée,Philippe de CraeneINAKAKOURA SAStel: 06 31 05 83 21
www.inakakoura.com

Le dimanche 17 septembre 2023 à 10:04:51 UTC+2, Philippe DC ***@***.***> a écrit :

Hi, Here is the last version of manual. I have v3 and v4, may be a last v2 I have to check.
It is 18€ shipping include. My Paypal is ***@***.***
Please note: according to the diagram, C8 / C9 must be a much smaller capacitive value than described: 100uF only. Otherwise T3 can break by current overflow when switching on.

Thanks,

Bonne journée,Philippe de CraeneINAKAKOURA SAStel: 06 31 05 83 21
www.inakakoura.com

Le dimanche 17 septembre 2023 à 09:56:40 UTC+2, dessis37 ***@***.***> a écrit :

Hi i live in denmark and whats the cost of the pcb?

Sendt fra Outlook til iOS<https://aka.ms/o0ukef>
________________________________
Fra: PhilippeDC ***@***.***>
Sendt: Sunday, September 17, 2023 9:53:16 AM
Til: philippedc/Arduino-Uno-Wind-Turbine-MPPT-Regulator ***@***.***>
Cc: dessis37 ***@***.***>; Author ***@***.***>
Emne: Re: [philippedc/Arduino-Uno-Wind-Turbine-MPPT-Regulator] pcb (Issue #4)

Hi Dennis, I can ship a PCB. Where do you live ?

Bonne journée,Philippe de CraeneINAKAKOURA SAStel: 06 31 05 83 21
www.inakakoura.com

Le samedi 16 septembre 2023 à 14:39:13 UTC+2, dessis37 ***@***.***> a écrit :

Can i buy the pcb of you or can i buy the pcb file?

Best regard dennis

—
Reply to this email directly, view it on GitHub, or unsubscribe.
You are receiving this because you are subscribed to this thread.Message ID: ***@***.***>

—
Reply to this email directly, view it on GitHub<https://github.com/philippedc/Arduino-Uno-Wind-Turbine-MPPT-Regulator/issues/4#issuecomment-1722417698>, or unsubscribe<https://github.com/notifications/unsubscribe-auth/A6QI6PQS56A4WE3HNINKIITX22T6ZANCNFSM6AAAAAA423T6JY>.
You are receiving this because you authored the thread.Message ID: ***@***.***>

—
Reply to this email directly, view it on GitHub, or unsubscribe.
You are receiving this because you commented.Message ID: ***@***.***>

—
Reply to this email directly, view it on GitHub<https://github.com/philippedc/Arduino-Uno-Wind-Turbine-MPPT-Regulator/issues/4#issuecomment-1722423784>, or unsubscribe<https://github.com/notifications/unsubscribe-auth/A6QI6PWM6S527TNBBZYS2GLX22X4VANCNFSM6AAAAAA423T6JY>.
You are receiving this because you authored the thread.Message ID: ***@***.***>

—
Reply to this email directly, view it on GitHub, or unsubscribe.
You are receiving this because you commented.Message ID: ***@***.***>

—
Reply to this email directly, view it on GitHub<https://github.com/philippedc/Arduino-Uno-Wind-Turbine-MPPT-Regulator/issues/4#issuecomment-1722425801>, or unsubscribe<https://github.com/notifications/unsubscribe-auth/A6QI6PW2QWXPMYPKEIPN7OTX22ZINANCNFSM6AAAAAA423T6JY>.
You are receiving this because you authored the thread.Message ID: ***@***.***>

philippedc, 2024-03-01:
hi you can contact me dcphilippe at yahoo dot fr
